xboard-io/openboard/README.md

# openboard
True Open Hardware Board designed with open source EDA.
