xboard-io/openboard/core/Doc/imx233-core-v6.11.pdf

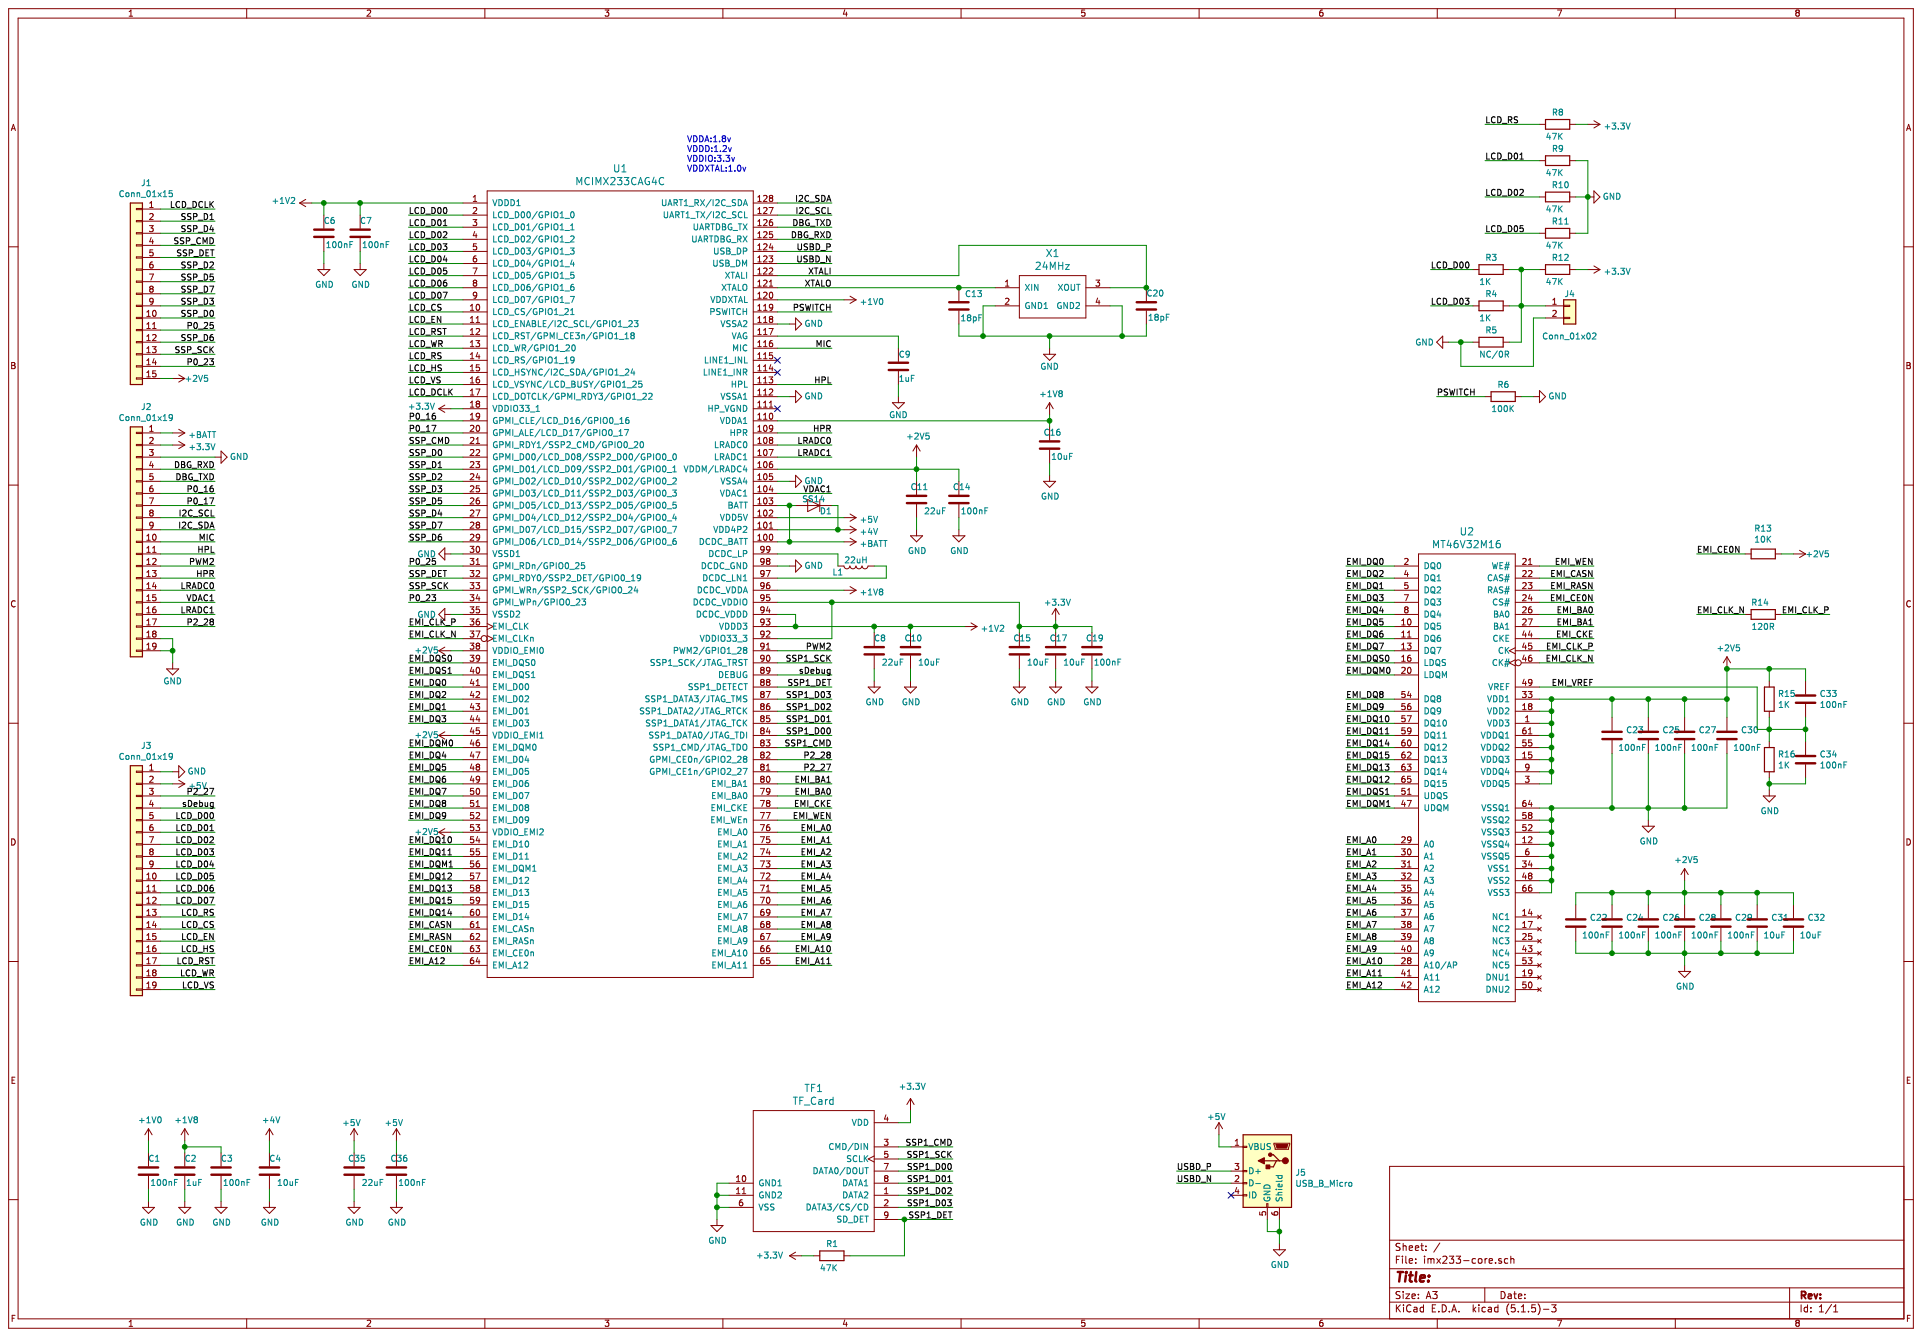
[picture p1: page 1]
