xboard-io/openboard/core/Prod/v6.12/bitmap.pdf

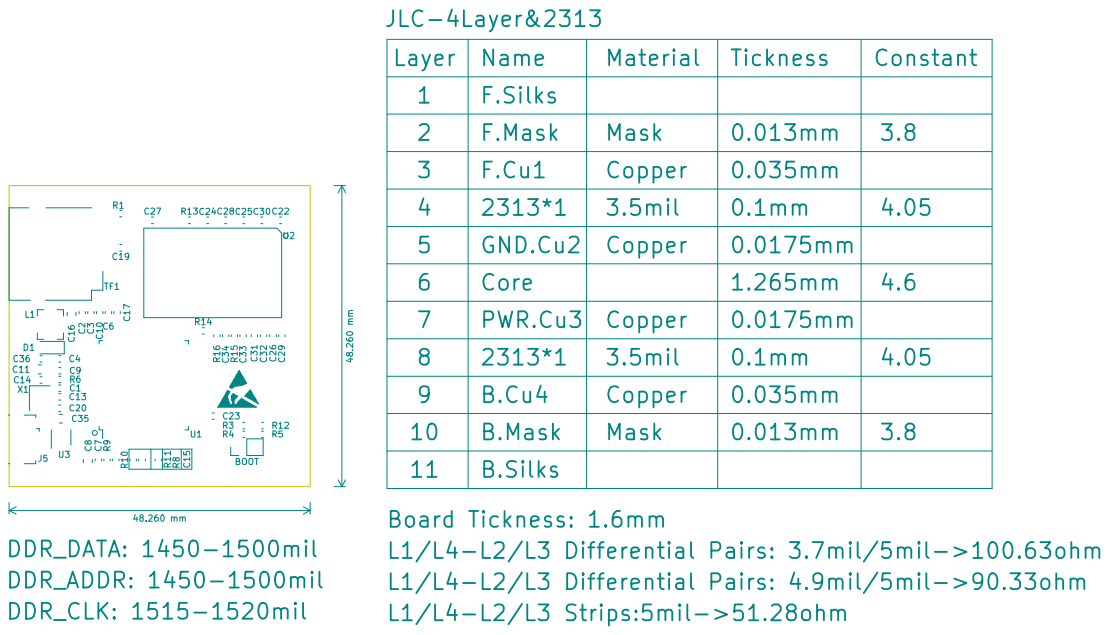
[picture p2: page 1]
