xboard-io/openboard/(commit log)

2020-08-30 core: initial commit of openboard 1900x1900mil hw design
    [imx233-core-B_Cu.gbr, imx233-core-B_Mask.gbr, imx233-core-B_Paste.gbr, imx233-core-B_SilkS.gbr, imx233-core-Edge_Cuts.gbr, imx233-core-F_Cu.gbr, imx233-core-F_Mask.gbr, imx233-core-F_Paste.gbr]
2020-09-01 core: Remove gerber plain files
    These files can be generated from pcb file.
    Move them into production directory as reference package.
    [imx233-core-B_Cu.gbr, imx233-core-B_Mask.gbr, imx233-core-B_Paste.gbr, imx233-core-B_SilkS.gbr, imx233-core-Edge_Cuts.gbr, imx233-core-F_Cu.gbr, imx233-core-F_Mask.gbr, imx233-core-F_Paste.gbr]
2020-09-01 core: Add ESD protection to USB
    Update mx233 symbol & footprint library.
    [imx233-core.kicad_pcb, imx233-core.sch]
2020-09-01 core: Add some datasheet and production files
    v6.11 & v6.12 production files of gerber, bom, bitmap, position map
    and steel mask manufacture docs.
    [BOM.csv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]
