xboard-io/openboard/(notices)

Notices in the files:
core/imx233-core.kicad_pcb:
TAPR Open Hardware License (www.tapr.org/OHL)
Licensed under the
